robgmsn/PureVCA/readme.md

DESIGN STATUS: Production

VCA Updated to V2.31 14/4/21

Library updated to include 3D models.
Traces rerouted.
Weird shorted cap removed. WTF?
Values tweaked for better CV response.
