robgmsn/PureVCA/Pure VCA.brd

## EAGLE design Pure VCA.brd (2021-04-27)

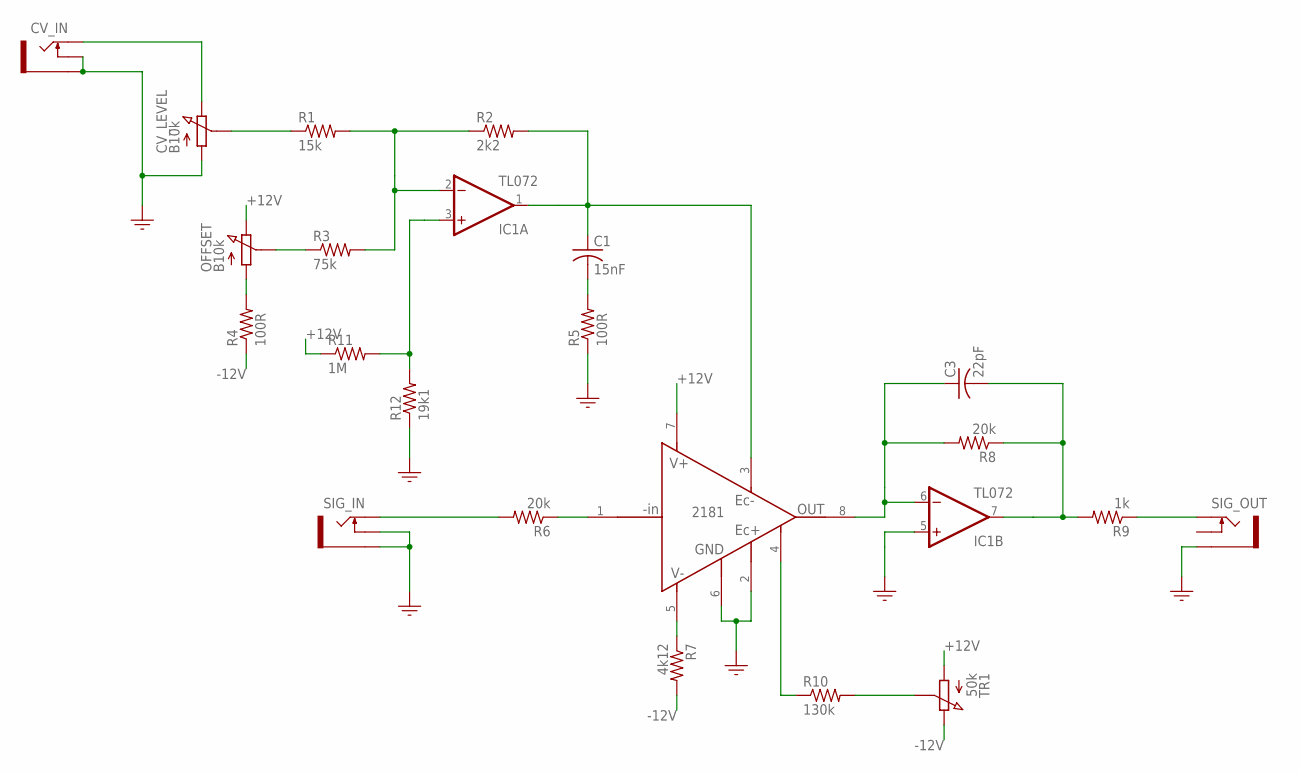
[picture p1: schematic Pure VCA.sch, sheet 1]

Parts:
C1: 15nF; C0805
C3: 22pF; C0805
CV_IN: PJ301M-12
CV_LEVEL: B10k; POT_9MM_GREEN_KNOB
IC1: TL072; SO08
IC2: THAT2181; SOIC--8
OFFSET: B10k; POT_9MM_BLUE_KNOB
R1: 15k; R0805
R2: 2k2; R0805
R3: 75k; R0805
R4, R5: 100R; R0805
R6, R8: 20k; R0805
R7: 4k12; R0805
R9: 1k; R0805
R10: 130k; R0805
R11: 1M; R0805
R12: 19k1; R0805
SIG_IN: PJ301M-12
SIG_OUT: PJ301M-12
TR1: 50k; TRIMMER_TH

Connections:
+12V: IC2.7 (V+), OFFSET.P$3 (3), R11.1, TR1.1; also elsewhere on the board
-12V: R4.1, R7.2, TR1.3; also elsewhere on the board
GND: CV_IN.GND (SLEEVE), CV_IN.NORM (SWITCH), CV_LEVEL.P$1 (1), IC1.5 (+IN), IC2.2 (EC+), IC2.6 (GND), R5.1, R12.1, SIG_IN.GND (SLEEVE), SIG_IN.NORM (SWITCH), SIG_OUT.GND (SLEEVE); also elsewhere on the board
unnamed: CV_IN.TIP, CV_LEVEL.P$3 (3)
unnamed: IC1.2 (-IN), R1.2, R2.1, R3.2
unnamed: CV_LEVEL.P$2 (2), R1.1
unnamed: OFFSET.P$1 (1), R4.2
unnamed: C1.1, IC1.1 (OUT), IC2.3 (EC-), R2.2
unnamed: OFFSET.P$2 (2), R3.1
unnamed: C1.2, R5.2
unnamed: R9.1, SIG_OUT.TIP
unnamed: IC2.1 (-IN), R6.1
unnamed: R6.2, SIG_IN.TIP
unnamed: IC2.5 (V-), R7.1
unnamed: IC1.3 (+IN), R11.2, R12.2
unnamed: C3.1, IC1.6 (-IN), IC2.8 (OUT), R8.2
unnamed: C3.2, IC1.7 (OUT), R8.1, R9.2
unnamed: IC2.4 (SYM), R10.1
unnamed: R10.2, TR1.2

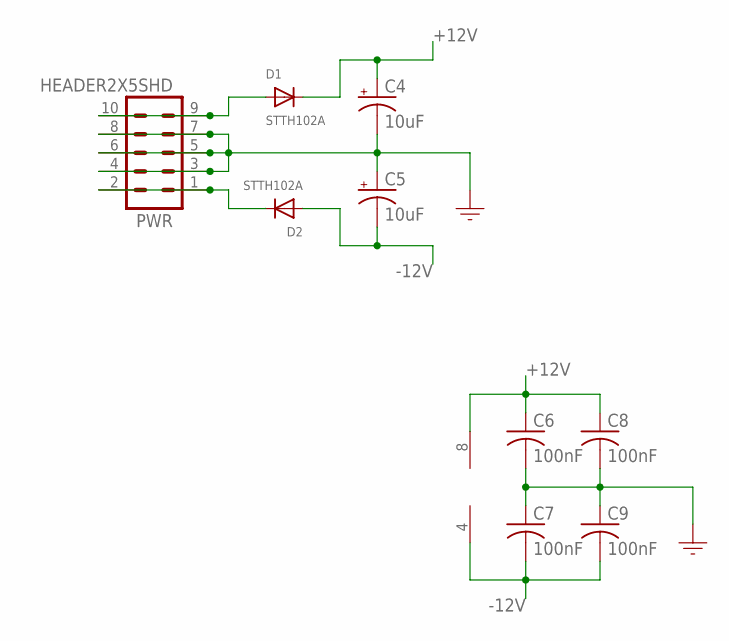
[picture p2: schematic Pure VCA.sch, sheet 2]

Parts:
C4, C5: 10uF; 153CLV-0505
C6, C7, C8, C9: 100nF; C0805
D1, D2: STTH102A; SMADIODE
IC1: TL072; SO08
PWR: HEADER2X5SHD; 2X5-SHROUDED

Connections:
+12V: C4.+, C6.1, C8.1, D1.C, IC1.8 (V+); also elsewhere on the board
-12V: C5.-, C7.2, C9.2, D2.A, IC1.4 (V-); also elsewhere on the board
GND: C4.-, C5.+, C6.2, C7.1, C8.2, C9.1, PWR.3, PWR.4, PWR.5, PWR.6, PWR.7, PWR.8; also elsewhere on the board
unnamed: D1.A, PWR.9, PWR.10
unnamed: D2.C, PWR.1, PWR.2

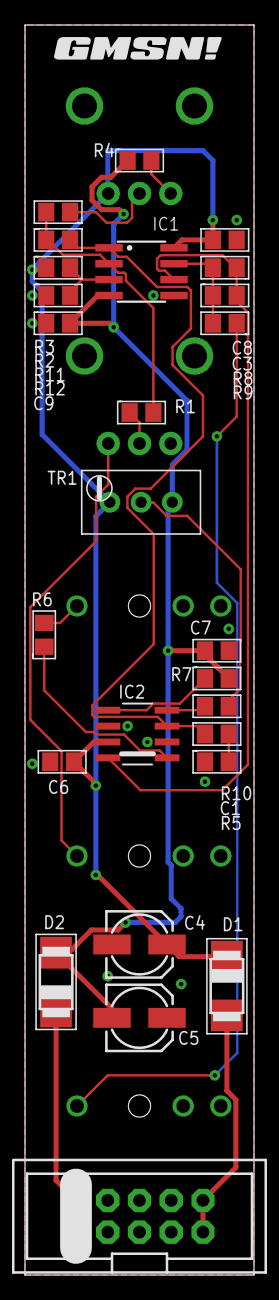
[picture p3: board Pure VCA.brd from above]

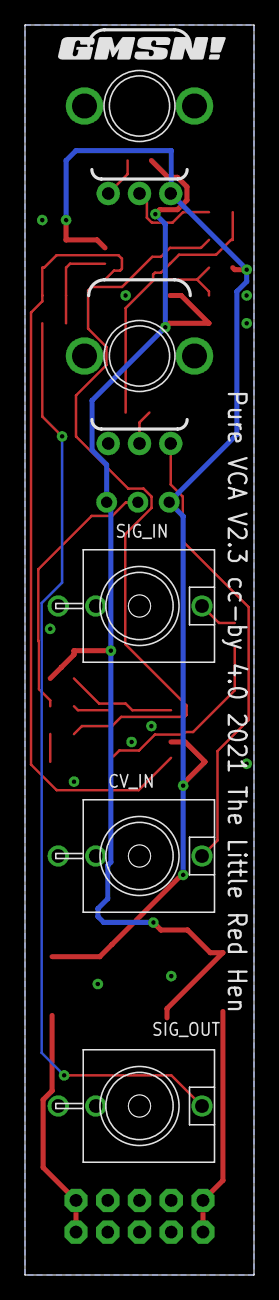
[picture p4: board Pure VCA.brd from below]

Board: 2 copper layers, 18.3 x 100.0 mm, 33 parts (6 on the bottom side), 21 nets.

Other parts of the board:
U$1, U$2: GMSN!_LOGO
