robgmsn/PureVCA/(commit log)

2021-04-16 VCA 2.1
    Converted to SMD and changed from RS Design Spark to Eagle
    [Pure VCA.brd, Pure VCA.sch]
2021-04-16 VCA 2.2
    [Pure VCA.brd, Pure VCA.sch]
2021-04-16 VCA 2.3
    VCA Updated to V2.3 14/4/21
    Library updated to include 3D models.
    Traces rerouted.
    Weird shorted cap removed. WTF?
    [Pure VCA PCB Panel.brd, Pure VCA.brd, Pure VCA.csv, Pure VCA.sch]
2021-04-27 VCA 2.31
    VCA Updated to V2.31 14/4/21
    Values tweaked for better CV response.
    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
    [Pure VCA.brd, Pure VCA.csv, Pure VCA.sch]
