robgmsn/PureVCA/(notices)

Notices in the files:
Pure VCA.brd:
Pure VCA V2.3 cc-by 4.0 2021 The Little Red Hen
